Abdulaziz-kh-Hatem/graduation-project/thesis/00_Frontmatter/01_Title_Page.tex

% ============================================================
% Title Page (Official UST Past-Year Matching Standard)
% ============================================================
\begin{titlepage}
\centering

\vspace*{-0.4cm}

% --- Header Information ---
{\fontsize{13}{16}\selectfont\bfseries Republic of Yemen}\\[0.12cm]
{\fontsize{14}{17}\selectfont\bfseries University of Science and Technology}\\[0.12cm]
{\fontsize{13}{16}\selectfont\bfseries Faculty of Engineering and Computing}\\[0.1cm]
{\fontsize{12}{15}\selectfont\bfseries Department of Biomedical Engineering}\\[0.35cm]

% --- Official University Logo ---
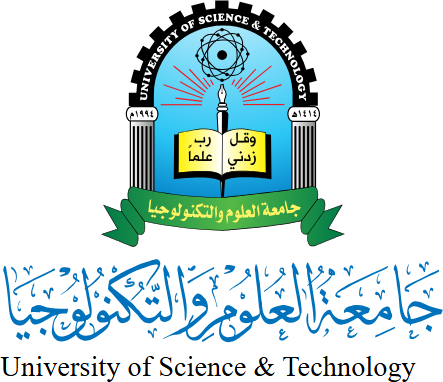
[picture p6: thesis/03_Figures/ust_logo.png]
\\[0.35cm]

% --- Upper Divider Rule ---
\rule{0.92\textwidth}{1.2pt}\\[0.45cm]

% --- Project Title (Crisp, Proportional Size) ---
{\fontsize{15}{21}\selectfont\bfseries Design and Implementation of an Integrated\\
EOG-Based Human-Computer Interface for\\
Virtual Keyboard and Wheelchair Control}\\[0.45cm]

% --- Lower Divider Rule ---
\rule{0.92\textwidth}{1.2pt}\\[0.5cm]

% --- Research Prepared by Section ---
{\fontsize{12}{15}\selectfont\bfseries Research prepared by:}\\[0.25cm]
{\fontsize{11}{16}\selectfont
1. Abdulaziz Khaled Abdulaziz Hatem\\[0.08cm]
2. Ahmed Mohammed Ahmed Salem Al-Kadhi\\[0.08cm]
3. Mohammed Ayman Ali Qasem\\[0.08cm]
4. Khaled Abdulmajid Mohammed Farhan}\\[0.5cm]

% --- Supervised by Section ---
{\fontsize{12}{15}\selectfont\bfseries Supervised by:}\\[0.2cm]
{\fontsize{11}{15}\selectfont Dr. Nasr Kaid Ali AL-Audi}\\[0.6cm]

% --- Degree Statement (Exact Official Wording) ---
{\fontsize{10.5}{14}\selectfont\itshape (To the Faculty of Engineering and Computing, This Research is a Part of the\\
Requirements for Obtaining a Bachelor's Degree in Biomedical Engineering)}\\[0.4cm]

\vfill

% --- Academic Year ---
{\fontsize{11}{14}\selectfont\bfseries 2025 - 2026}

\end{titlepage}
