Abdulaziz-kh-Hatem/graduation-project/thesis/00_Frontmatter/08_List_of_Abbreviations.tex

% ============================================================
% List of Abbreviations
% ============================================================
\chapter*{List of Abbreviations}
\addcontentsline{toc}{chapter}{List of Abbreviations}

\begin{longtable}{@{}p{3cm}p{10cm}@{}}
\toprule
\textbf{Abbreviation} & \textbf{Description} \\
\midrule
\endhead
ADC   & Analog-to-Digital Converter \\
BMS   & Battery Management System \\
CMRR  & Common-Mode Rejection Ratio \\
EEG   & Electroencephalography \\
EMG   & Electromyography \\
EOG   & Electrooculography \\
FSM   & Finite State Machine \\
GUI   & Graphical User Interface \\
HPF   & High-Pass Filter \\
LIS   & Locked-in Syndrome \\
LPF   & Low-Pass Filter \\
MCU   & Microcontroller Unit \\
PCB   & Printed Circuit Board \\
PWM   & Pulse-Width Modulation \\
\bottomrule
\end{longtable}
