Abdulaziz-kh-Hatem/graduation-project/thesis/02_Appendices/Appendix_A.tex

% ============================================================
% Appendix A: Source Codes & System Schematics
% ============================================================
\chapter{Source Codes \& System Schematics}
\label{app:appendix_a}

\chapteroverview{This appendix provides the complete embedded firmware source codes, MATLAB bio-signal processing scripts, and hardware circuit schematics for the EOG-guided assistive platform.}

\section{Source Codes}
\label{sec:app_codes}

\subsection{MATLAB EOG Signal Processing and Blink Detection Algorithm}
\label{subsec:app_matlab_code}
% Add MATLAB blink detection algorithm code here

\subsection[Arduino Firmware for Prototype Wheelchair Navigation]{Arduino Embedded Firmware for 3D-Printed Prototype Wheelchair Navigation}
\label{subsec:app_arduino_code}
% Add Arduino firmware code here

\section{System Schematics and PCB Layouts}
\label{sec:app_schematics}

\subsection{AD620 Bio-Amplifier and Active Filter Schematic}
\label{subsec:app_schematic_analog}
% Add analog schematic here

\subsection{Arduino and Motor Driver Wiring Diagram}
\label{subsec:app_schematic_digital}
% Add digital wiring diagram here
