Abdulaziz-kh-Hatem/graduation-project/thesis/01_Chapters/Chapter1/1.5_Timeline.tex

% ============================================================
% Section 1.5: Project Execution Timeline
% ============================================================
\section{Project Execution Timeline}
\label{sec:project_execution_timeline}

The development lifecycle of this project was systematically organized across two academic years (within the four-year Biomedical Engineering curriculum).

During Year 3, efforts focused on EOG signal acquisition, continuous hardware design, noise suppression, and circuit optimization until a stable signal output was achieved. Building upon this hardware foundation, Year 4 focused on software development, virtual keyboard GUI programming, finite state machine integration, 3D printing of the prototype vehicle, and wireless control integration. Table \ref{tab:project_timeline} summarizes the engineering milestones achieved across this timeline.

\begin{table}[H]
  \centering
  \caption{Two-Year Project Execution Timeline (Year 3 -- Year 4)}
  \label{tab:project_timeline}
  \begin{tabularx}{\textwidth}{l X c}
    \toprule
    \textbf{Stage} & \textbf{Engineering Task \& Technical Focus} & \textbf{Academic Period} \\
    \midrule
    Phase 1 & Clinical background research, initial EOG signal acquisition, and preliminary analog circuit prototyping & Year 3 -- Semester 1 \\
    Phase 2 & Hardware optimization, active filter tuning, and achieving stable signal acquisition & Year 3 -- Semester 2 \\
    Phase 3 & Virtual keyboard programming (GUI), FSM control logic implementation, and signal algorithm refinement & Year 4 -- Semester 1 \\
    Phase 4 & 3D-printed vehicle construction, wireless control integration, system validation testing, and final documentation & Year 4 -- Semester 2 \\
    \bottomrule
  \end{tabularx}
\end{table}
