Abdulaziz-kh-Hatem/graduation-project/thesis/01_Chapters/Chapter3/Ch3_Main.tex

% ============================================================
% Chapter 3: System Architecture and Block Diagram
% ============================================================
\chapter{System Architecture and Block Diagram}
\label{ch:block_diagram}

\chapteroverview{This chapter details the high-level architecture and operational behavioral logic of the EOG-guided assistive system. It presents the overall system block diagram detailing the input, processing, output, and power management units, followed by functional operational descriptions. Additionally, it outlines the software flowcharts for MATLAB EOG thresholding, unified mode switching, and Arduino obstacle avoidance. In strict accordance with system modeling standards, component-level hardware specifications are omitted from this chapter.}

\input{01_Chapters/Chapter3/3.1_System_Block_Diagram}
\input{01_Chapters/Chapter3/3.2_Functional_Description}
\input{01_Chapters/Chapter3/3.3_System_Flowchart}

% --- Chapter Conclusion & Transition ---
\vspace{1em}
To summarize, this chapter established the high-level architectural framework, mode switching logic, and operational flowcharts governing wheelchair navigation and virtual speller control. Having finalized the abstract functional workflow, Chapter 4 transitions to physical hardware realization, detailing circuit simulations, IC specifications (AD620, L298N), mathematical design calculations, and the hybrid software implementation.
