Abdulaziz-kh-Hatem/graduation-project/thesis/01_Chapters/Chapter4/4.6_Complete_System_Integration.tex

% ============================================================
% Section 4.6: Complete System Integration
% ============================================================
\section{Complete System Integration}
\label{sec:system_integration_experimental_setup}

The successful integration of the aforementioned subsystems resulted in a unified, functional Human-Computer Interface (HCI). During the experimental trials, surface electrodes were applied to the user’s periorbital region. The raw biopotentials were processed by the breadboard analog front-end, monitored in real-time via a digital oscilloscope to verify noise rejection, and simultaneously digitized by the microcontroller. The MATLAB processing engine successfully decoded these signals to wirelessly drive the 3D-printed wheelchair and operate the virtual speller interface without critical latency or system failure.

\begin{figure}[H]
\centering

\caption{Complete experimental setup demonstrating real-time EOG signal acquisition, hardware conditioning on the breadboard, MATLAB digital processing on the host machine, and signal verification via oscilloscope.}
\label{fig:complete_experimental_hci_setup}
\end{figure}
