Abdulaziz-kh-Hatem/graduation-project/thesis/01_Chapters/Chapter4/Ch4_Main.tex

% ============================================================
% Chapter 4: Circuit Simulation and Hardware Implementation
% ============================================================
\chapter{Circuit Simulation and Hardware Implementation}
\label{ch:implementation}

\chapteroverview{This chapter details the physical hardware component specifications, analog circuit simulations, mathematical calculations, breadboard prototyping, embedded safety systems, 3D-printed wheelchair chassis, and complete physical system integration of the EOG-guided assistive platform.}

\input{01_Chapters/Chapter4/4.1_Hardware_Components_Specifications}
\input{01_Chapters/Chapter4/4.2_Analog_Circuit_Simulation_Math}
\input{01_Chapters/Chapter4/4.3_Analog_Front_End_Realization}
\input{01_Chapters/Chapter4/4.4_Embedded_Control_Safety}
\input{01_Chapters/Chapter4/4.5_Mechanical_Design_Chassis}
\input{01_Chapters/Chapter4/4.6_Complete_System_Integration}

% --- Chapter Conclusion & Transition ---
\vspace{1em}
In conclusion, this chapter presented the hardware component specifications, circuit simulations, mathematical design validation, breadboard front-end realization, embedded control and safety systems, 3D-printed wheelchair chassis design, and complete system integration. With the hardware physical platform fully operational, Chapter 5 presents the quantitative experimental testing results, waveform analyses, obstacle avoidance evaluations, and statistical accuracy metrics.
