Abdulaziz-kh-Hatem/graduation-project/thesis/01_Chapters/Chapter5/Ch5_Main.tex

% ============================================================
% Chapter 5: Results and Discussion
% ============================================================
\chapter{Results and Discussion}
\label{ch:results}

\chapteroverview{This chapter presents the experimental validation and quantitative performance analysis of the integrated EOG-guided wheelchair and virtual speller platform. It evaluates raw vs. filtered EOG biopotential waveforms, DC offset cancellation, 4-blink threshold mode switching performance, autonomous obstacle avoidance response times, and virtual speller typing efficacy. Finally, it provides photographic documentation of the complete physical prototype and analyzes statistical command execution accuracy across 1000 test trials and cited Scopus literature.}

\input{01_Chapters/Chapter5/5.1_Results_Presentation}
\input{01_Chapters/Chapter5/5.2_Results_Discussion}
\input{01_Chapters/Chapter5/5.3_Navigation_Results}
\input{01_Chapters/Chapter5/5.4_Virtual_Keyboard_Results}
\input{01_Chapters/Chapter5/5.5_Final_Prototype_Accuracy}
\input{01_Chapters/Chapter5/5.6_Statistical_Evaluation}

% --- Chapter Conclusion & Transition ---
\vspace{1em}
In summary, experimental testing confirmed high operational reliability across all functional modes. The system achieved an overall command execution accuracy of $95.7\%$ with an $85\,\text{ms}$ emergency stop response time across 1000 macro-level trials. The detailed per-subject evaluation further demonstrated a combined system accuracy of $91.5\%$, a mean wheelchair navigation latency of $143.0\,\text{ms}$, and an average speller throughput of $16.0\,\text{CPM}$, with performance improving markedly with operator acclimatization. Having thoroughly evaluated and discussed the quantitative results, Chapter~6 concludes the report by summarizing the significant engineering discoveries, discussing practical clinical applications, and proposing future research directions.
