Abdulaziz-kh-Hatem/graduation-project/thesis/01_Chapters/Chapter6/6.1_Conclusion.tex

% ============================================================
% Section 6.1: Conclusions and Significant Discoveries
% ============================================================
\section{Conclusions and Significant Discoveries}
\label{sec:conclusions_discoveries}

This project developed and tested an integrated Electrooculography (EOG)-based assistive platform for individuals with severe neuromuscular impairments, including quadriplegia and locked-in syndrome (LIS). The system integrates physical mobility (prototype motorized wheelchair) and text communication (virtual Arabic keyboard) within a unified architecture, utilizing a single vertical biopotential acquisition channel. Quantitative testing across $N = 5$ healthy subjects (60 total trials) demonstrated an overall command execution accuracy of 91.5\%--92.0\%, validating the analog active filters and temporal peak discrimination logic. The virtual keyboard achieved an average typing speed of 16.0 Characters Per Minute (CPM) during standardized Arabic phrase testing. An ultrasonic sensor array (40 cm front / 30 cm rear thresholds) provided obstacle avoidance via microcontroller interrupts (70.0 ms response latency) and in-place escape rotations.
