Abdulaziz-kh-Hatem/graduation-project/thesis/01_Chapters/Chapter6/6.2_Clinical_Applications.tex

% ============================================================
% Section 6.2: Practical and Clinical Applications
% ============================================================
\section{Practical and Clinical Applications}
\label{sec:practical_clinical_applications}

The prototype demonstrates engineering feasibility as a low-cost assistive interface across several potential application domains:

\begin{itemize}
    \item \textbf{Hospitals and Rehabilitation Centers:} Serves as a non-invasive evaluation and communication tool for newly diagnosed motor-impaired patients, enabling early functional interaction before advanced speech loss or muscle atrophy occurs.

    \item \textbf{Assistive Home Care Environments:} Grants LIS and ALS patients independent physical mobility and digital text communication within home settings, substantially reducing constant caregiver dependency and financial burden.

    \item \textbf{Low-Cost Assistive Alternative:} Provides an accessible alternative to high-cost commercial eye-tracking systems, making assistive Human-Machine Interfaces (HMIs) viable in resource-constrained settings.
\end{itemize}
