Abdulaziz-kh-Hatem/graduation-project/thesis/01_Chapters/Chapter6/6.3_Recommendations.tex

% ============================================================
% Section 6.3: Recommendations for Future Studies
% ============================================================
\section{Recommendations for Future Studies}
\label{sec:future_recommendations}

Based on the operational boundaries and technical insights identified during development, future engineering endeavors should focus on the following key advancements:

\begin{itemize}
    \item \textbf{Real Electric Wheelchair Integration:} Transitioning from the laboratory prototype vehicle to a full-scale, commercially available motorized electric wheelchair. This involves interfacing the embedded control drivers directly with high-torque industrial DC motors and power actuators capable of supporting real patient payloads in everyday indoor and outdoor environments.

    \item \textbf{Fully Integrated Standalone System:} Eliminating reliance on a laptop host computer and MATLAB software by embedding all signal conditioning, dynamic thresholding, and state-machine algorithms into a unified, high-performance microcontroller (e.g., ESP32 or ARM Cortex architecture). This creates a single, self-contained embedded module mounted directly on the wheelchair chassis.

    \item \textbf{Embedded Machine Learning Classification:} Incorporating lightweight Machine Learning (ML) classifiers (such as Support Vector Machines) or adaptive noise cancellation filters to suppress motion artifacts caused by head tilt and involuntary facial expressions during navigation.

    \item \textbf{Hardware Miniaturization and Power Optimization:} Redesigning the Analog Front-End (AFE) onto a miniaturized surface-mount device (SMD) PCB integrated into a wearable headset, supported by a dedicated Battery Management System (BMS) with inductive charging capabilities.
\end{itemize}
