Abdulaziz-kh-Hatem/graduation-project/thesis/main.tex

% ============================================================
% main.tex - Graduation Project Report
% University of Science and Technology
% Faculty of Engineering - Biomedical Engineering Department
% ============================================================
% Engine: XeLaTeX | Bibliography: biblatex + biber
% ============================================================

\documentclass[12pt, a4paper, oneside]{report}

% ============================================================
% PACKAGES
% ============================================================

% --- Encoding & Fonts ---
\usepackage{fontspec}
\setmainfont{times.ttf}[BoldFont=timesbd.ttf, ItalicFont=timesi.ttf, BoldItalicFont=timesbi.ttf]
\newfontfamily\arabicfont[Script=Arabic, Scale=1.15, BoldFont=artrbdo.ttf, ItalicFont=artro.ttf, ItalicFeatures={AutoFakeSlant=0.18}, BoldItalicFont=artrbdo.ttf, BoldItalicFeatures={AutoFakeSlant=0.18}]{artro.ttf}
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

% --- Table of Contents, List of Figures/Tables ---
\usepackage{tocloft}
\renewcommand{\cftchapleader}{\cftdotfill{\cftdotsep}}
\renewcommand{\cfttoctitlefont}{\hfill\fontsize{14}{18}\bfseries}
\renewcommand{\cftaftertoctitle}{\hfill}
\renewcommand{\cftloftitlefont}{\hfill\fontsize{14}{18}\bfseries}
\renewcommand{\cftafterloftitle}{\hfill}
\renewcommand{\cftlottitlefont}{\hfill\fontsize{14}{18}\bfseries}
\renewcommand{\cftafterlottitle}{\hfill}
\renewcommand{\cftchappresnum}{Chapter }
\setlength{\cftchapnumwidth}{6.5em}

% --- Graphics ---
\usepackage{graphicx}
\graphicspath{
  {03_Figures/}
  {03_Figures/Ch1/}
  {03_Figures/Ch2/}
  {03_Figures/Ch3/}
  {03_Figures/Ch4/}
  {03_Figures/Ch5/}
  
}

% --- Tables ---
\usepackage{booktabs}
\usepackage{array}
\usepackage{multirow}
\usepackage{longtable}
\usepackage{tabularx}

% --- Captions ---
\usepackage[font={singlespacing,small}, labelfont=bf, labelsep=colon]{caption}
% Table caption on top, figure caption on bottom (university requirement)
\captionsetup[table]{position=above}
\captionsetup[figure]{position=below}

% --- Mathematics ---
\usepackage{amsmath}
\usepackage{amssymb}
\usepackage{amsfonts}
\providecommand{\UseMathForPositioningText}{}

% --- Units ---
\usepackage{siunitx}

% --- TikZ Diagrams ---
\usepackage{tikz}
\usetikzlibrary{shapes.geometric, arrows.meta, positioning, calc, shadows}

% --- Code Listings ---
\usepackage{listings}
\lstset{
  basicstyle=\small\ttfamily,
  breaklines=true,
  frame=single,
  numbers=left,
  numberstyle=\tiny,
  tabsize=4,
  captionpos=b
}

% --- Cross References & Hyperlinks ---
\usepackage[
  colorlinks=true,
  linkcolor=black,
  citecolor=black,
  urlcolor=blue,
  bookmarks=true,
  bookmarksopen=true,
  pdfstartview=FitH
]{hyperref}
\usepackage{bookmark}

% --- Bibliography (IEEE / Numeric Style) ---
\usepackage[
  backend=biber,
  style=numeric,
  sorting=none,
  natbib=true,
  maxcitenames=2,
  maxbibnames=99
]{biblatex}
\addbibresource{references.bib}
% Single-spacing within reference entries and double-spacing between entries
\setlength{\bibitemsep}{2\baselineskip}
\renewcommand{\bibfont}{\normalfont\fontsize{12}{14}\selectfont}

% --- Appendices ---
\usepackage[toc, page]{appendix}

% --- Abbreviations ---
% (Using manual longtable in 07_Abbreviations.tex instead of glossaries package)

% --- List Formatting (University & Academic Standards) ---
\usepackage{enumitem}
\setlist[itemize,1]{label=\textbullet, leftmargin=1.5em, itemsep=3pt, parsep=0pt, topsep=4pt}
\setlist[itemize,2]{label=\textendash, leftmargin=1.5em, itemsep=2pt, parsep=0pt, topsep=2pt}
\setlist[itemize,3]{label=\textcirc, leftmargin=1.5em, itemsep=2pt, parsep=0pt, topsep=2pt}
\setlist[enumerate,1]{label=\textbf{\arabic*.}, leftmargin=1.5em, itemsep=3pt, parsep=0pt, topsep=4pt}
\setlist[enumerate,2]{label=\textbf{(\alph*)}, leftmargin=1.5em, itemsep=2pt, parsep=0pt, topsep=2pt}

% --- Orphan and Widow Control ---
\clubpenalty=10000
\widowpenalty=10000
\displaywidowpenalty=10000

\usepackage{float}
\usepackage{placeins}
\usepackage{subcaption}
\usepackage{pdfpages}

% --- Float Placement Parameters ---
\renewcommand{\topfraction}{0.85}
\renewcommand{\bottomfraction}{0.85}
\renewcommand{\textfraction}{0.15}
\renewcommand{\floatpagefraction}{0.75}

% ============================================================
% CUSTOM COMMANDS
% ============================================================

% Arabic text inline
\newcommand{\ar}[1]{\textarabic{#1}}

% ============================================================
% DOCUMENT METADATA
% ============================================================

\hypersetup{
  pdftitle={Graduation Project Report},
  pdfauthor={Student Name},
  pdfsubject={Biomedical Engineering Graduation Project},
  pdfkeywords={EOG, Wheelchair, Arabic Keyboard, Biomedical Engineering}
}

% ============================================================
% DOCUMENT BEGIN
% ============================================================
\begin{document}

% --- Front Matter (Roman numerals) ---
\pagenumbering{roman}
\pagestyle{plain}

% Title Page
\input{00_Frontmatter/01_Title_Page}

% Dedication
\input{00_Frontmatter/02_Dedication}

% Acknowledgments
\input{00_Frontmatter/03_Acknowledgments}

% Abstract
\input{00_Frontmatter/04_Abstract}

% Table of Contents
\input{00_Frontmatter/05_Table_of_Contents}

% List of Tables
\input{00_Frontmatter/06_List_of_Tables}

% List of Figures
\input{00_Frontmatter/07_List_of_Figures}

% Abbreviations
\input{00_Frontmatter/08_List_of_Abbreviations}

% --- Main Matter (Arabic numerals) ---
\pagenumbering{arabic}
\pagestyle{fancy}

% Chapter 1: Introduction
\input{01_Chapters/Chapter1/Ch1_Main}

% Chapter 2: Medical & Engineering Background and Literature Review
\input{01_Chapters/Chapter2/Ch2_Main}

% Chapter 3: Block Diagram
\input{01_Chapters/Chapter3/Ch3_Main}

% Chapter 4: Circuit Simulation & Implementation
\input{01_Chapters/Chapter4/Ch4_Main}

% Chapter 5: Results & Discussion
\input{01_Chapters/Chapter5/Ch5_Main}

% Chapter 6: Conclusion & Recommendation
\input{01_Chapters/Chapter6/Ch6_Main}

% --- References ---
\clearpage
\printbibliography[heading=bibintoc, title={References}]

\end{document}
