Abdulaziz-kh-Hatem/graduation-project/thesis/00_Frontmatter/02_Dedication.tex

% ============================================================
% Dedication (الإهداء) - Guaranteed Slanted/Italic Arabic
% ============================================================
\thispagestyle{empty}
\vspace*{\fill}

\begin{center}
\begin{Arabic}
{\fontsize{20}{24}\selectfont\bfseries\itshape الإهداء}
\end{Arabic}
\end{center}
\vspace{1.2cm}

\begin{center}
\begin{Arabic}
\fontsize{13}{24}\selectfont
\setstretch{1.65}
\itshape

الحمد لله الذي وهبنا الإرادة، وذلل لنا سبل العلم، وأعاننا بفضله حتى بلغنا تمام هذا العمل..\\[1.2em]

{\bfseries\itshape نهدي ثمرة جهدنا وسهرنا:}\\[1.2em]

إلى من كانت دعواتهم طوق نجاةٍ لنا في لحظات التعب، وإلى العيون التي سهرت تترقب نجاحنا.. آبائنا وأمهاتنا؛ كنزنا الأغلى، والسند الذي لا يميل.\\[1.2em]

إلى القلوب التي استلهمنا من صمتها الفكرة، ومن صلابة إرادتها العزيمة.. أصحاب الهمم من مرضى التصلب الجانبي الضموري، ومتلازمة المنحبس، والشلل الرباعي. نهديكم هذا الجهد بيقين وحب، عسى أن يكون يداً حانية ترد لكم شيئاً من استقلاليتكم، ونافذة أملٍ تكسر حاجز الصمت وتصلكم بالعالم.\\[1.2em]

إلى إخوتنا، دفء الأيام وملاذنا الآمن.. وإلى أصدقاء المسيرة ورفاق الدرب، الذين تقاسمنا معهم ثقل البدايات ولذة النهايات، وكانوا لنا خير سندٍ ورفقة.\\[1.2em]

وإلى كل قلبٍ آمن بنا، وساندنا ولو بكلمة تشجيع صادقة..\\[1.2em]

إليكم جميعاً نهدي هذا العمل المتواضع.

\end{Arabic}
\end{center}

\vspace*{\fill}
\clearpage
