Abdulaziz-kh-Hatem/graduation-project/thesis/01_Chapters/Chapter2/Ch2_Main.tex

% ============================================================
% Chapter 2: Literature Review and Theoretical Background
% ============================================================
\chapter{Literature Review and Theoretical Background}
\label{ch:background}

\chapteroverview{This chapter provides the theoretical and scientific foundation supporting the proposed integrated assistive system. It begins with the medical background necessary to understand the biophysical nature and origin of electrooculography (EOG) signals. It then discusses the fundamental engineering principles related to biomedical signal acquisition, digital signal processing, and physical control systems. Furthermore, the chapter presents a literature review of previous studies in the field of eye-tracking and biomedical assistive technologies. Finally, it concludes by highlighting the advantages of the adopted technical approach and demonstrating the technical feasibility of this integrated design.}

\input{01_Chapters/Chapter2/2.1_Medical_Background}
\input{01_Chapters/Chapter2/2.2_Engineering_Background}
\input{01_Chapters/Chapter2/2.3_Literature_Review}
\input{01_Chapters/Chapter2/2.4_Proposed_Technique_Advantages}

% --- Chapter Conclusion & Transition ---
\vspace{1em}
In conclusion, this chapter synthesized the physiological basis of EOG signals, biopotential conditioning electronics, and relevant academic literature. The established advantages of real-time responsiveness and unified hardware integration form the structural parameters for system design. Building upon these theoretical principles, Chapter 3 details the high-level functional block diagrams, operational mode switching logic, and system flowcharts.
