Abdulaziz-kh-Hatem/graduation-project/thesis/01_Chapters/Chapter6/Ch6_Main.tex

% ============================================================
% Chapter 6: Conclusion and Recommendations
% ============================================================
\chapter{Conclusion and Recommendations}
\label{ch:conclusion}

\chapteroverview{This chapter synthesizes the primary engineering achievements and analytical conclusions of the project. It outlines the practical clinical applications of the integrated platform for motor-impaired individuals and presents strategic recommendations for future research and technical enhancement.}

\input{01_Chapters/Chapter6/6.1_Conclusion}
\input{01_Chapters/Chapter6/6.2_Clinical_Applications}
\input{01_Chapters/Chapter6/6.3_Recommendations}

% --- Chapter Conclusion & Summary ---
\vspace{1em}
In closing, this project demonstrated that a low-cost, unified EOG-guided platform can provide both mobility and communication assistance for individuals with severe motor impairments while maintaining operational reliability.
